BAUMAU1/FW-190---RC-AIRPLANE/Demo videos/Controller_backpack.jpeg

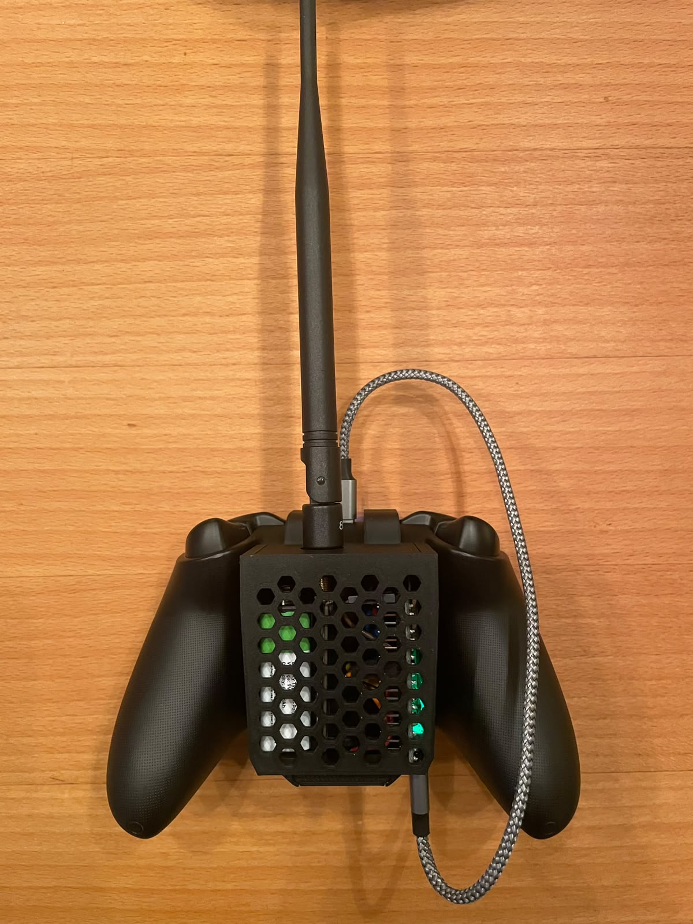
Demo videos/Controller_backpack.jpeg
