BAUMAU1/FW-190---RC-AIRPLANE/Demo videos/Nose-tray.jpeg

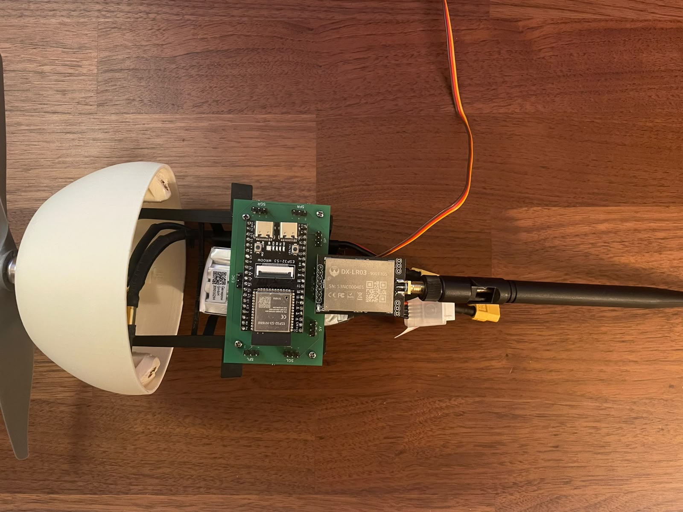
Demo videos/Nose-tray.jpeg
