BAUMAU1/FW-190---RC-AIRPLANE/Parts/BOM - Tabellenblatt1 (1).csv

Item name | Quantity | Price in Euro | Item link | Notes
ASA Aero Filament | 1 | 51,99 | https://eu.store.bambulab.com/de/products/asa-aero | Any other producer and other light weight filament works too
PETG Filament | 1 | 15,99 | https://eu.store.bambulab.com/de/products/petg-basic?id=703100873995440140 | Any other producer works too
ESP32 S3 CAM | 2 | 8,6 | https://www.ebay.de/itm/158230133114?_skw=ESP32-S3+CAM&itmmeta=01M6K4JS280QW6J4A2HHVTWYCD
DX-LR03 | 2 | 16,69 | https://de.aliexpress.com/item/1005008388886852.html?src=google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 | Two antennas needed, but only one order from this link
MG90S Servo | 4 | 16 | https://www.ebay.de/itm/157945572584 | One servo too much, but same price as less
Miuzei MS18 Servo | 1 | 6,99 | https://www.amazon.de/Miuzei-Hubschrauber-Helikopter-Fahrzeugmodelle-Steuerung/dp/B0BH6PD87V | Specific model because it will be deconstructed for specific parts
5V Step Down converter | 1 | 3,39 | https://www.ebay.de/itm/375340664282?_skw=step+down+5v&itmmeta=01M6K8TPDH68TE3QB4668P6WJX&var=644317386672
9V Battery | 1 | 9,9 | https://www.ebay.de/itm/389540519821?var=656860239995
1,5mm x 3 x 330mm springsteel wire | 1 | 3,5 | https://www.ebay.de/itm/175584943363?var=475856438007 | More wire than needed
2,5mm x 3 x 330 | 1 | 4,4 | https://www.ebay.de/itm/175584943363?var=475856438010 | Wire does not have to be cut prior to own modifications
3D-Weld | 1 | 13,5 | https://www.krickshop.de/Solid-Water-90-ml-DELUXE-Materials.htm?a=article&ProdNr=44110&p=1017
Heat Brass insert | 2 | 1,43 | https://eu.store.bambulab.com/de/products/round-threaded-brass-heat-insert-nut | M2x3,5x6
Heat Brass insert | 4 | 1,47 | https://eu.store.bambulab.com/de/products/round-threaded-brass-heat-insert-nut | M3x5x4
Heat Brass insert | 8 | 1,49 | https://eu.store.bambulab.com/de/products/round-threaded-brass-heat-insert-nut | M4x6x6
3D-print screw | 2 | 2,49 | https://eu.store.bambulab.com/de/products/bt2-6-socket-head-cap-self-tapping-screw-shcs | BT2,6x8
M2 DIN 7985 screws | 8 | 3,88 | https://www.ebay.de/itm/162173125805?_skw=M2+DIN+7985&itmmeta=01M6K5JG54YVW8JZZRQR3KY1AN&var=461146524234 | One order of 20 pieces of 8mm length
M2,5 DIN 7985 screws | 6 | 2,73 | https://www.ebay.de/itm/162173125925?var=461146524396 | One order of 20 pieces of 5mm length
M3 DIN 7985 screws | 4 | 3,82 | https://www.ebay.de/itm/162173126063?_skw=M3+DIN+7985&itmmeta=01M6K5YNHCN7N69640593T7MPP&var=461146524522 | One orer of 20 pieces of 10mm length
M4 DIN 7985 screws | 2 | 3,89 | https://www.ebay.de/itm/371713578736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 | One orer of 20 pieces of 10mm length
Back-wheel | 1 | 1,5 | https://www.krickshop.de/Zubehoer-Ersatzteile/Zubehoer-fuer-Flugmodelle/Raeder/Flugmodellrad-19mm-ALU-Felge.htm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
Front Wheels | 2 | 5,7 | https://www.krickshop.de/Zubehoer-Ersatzteile/Zubehoer-fuer-Flugmodelle/Raeder/Flug-Reifen-37mm-2-.htm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
AL2835-6 Motor | 1 | 33,9 | https://www.d-power-modellbau.com/motoren/brushless-motoren/d-power-al-serie---flug/d-power-al-2835-6-brushless-motor
Comet 40A BEC | 1 | 23,12 | https://www.modellbau-skeries.de/p/d-power-comet-40a-bec-brushless-regler | Does not have to be exact model
 | MAX. Price ==> | 244,97
