BAUMAU1/FW-190---RC-AIRPLANE/3D-model/Basic filament-parts.3mf

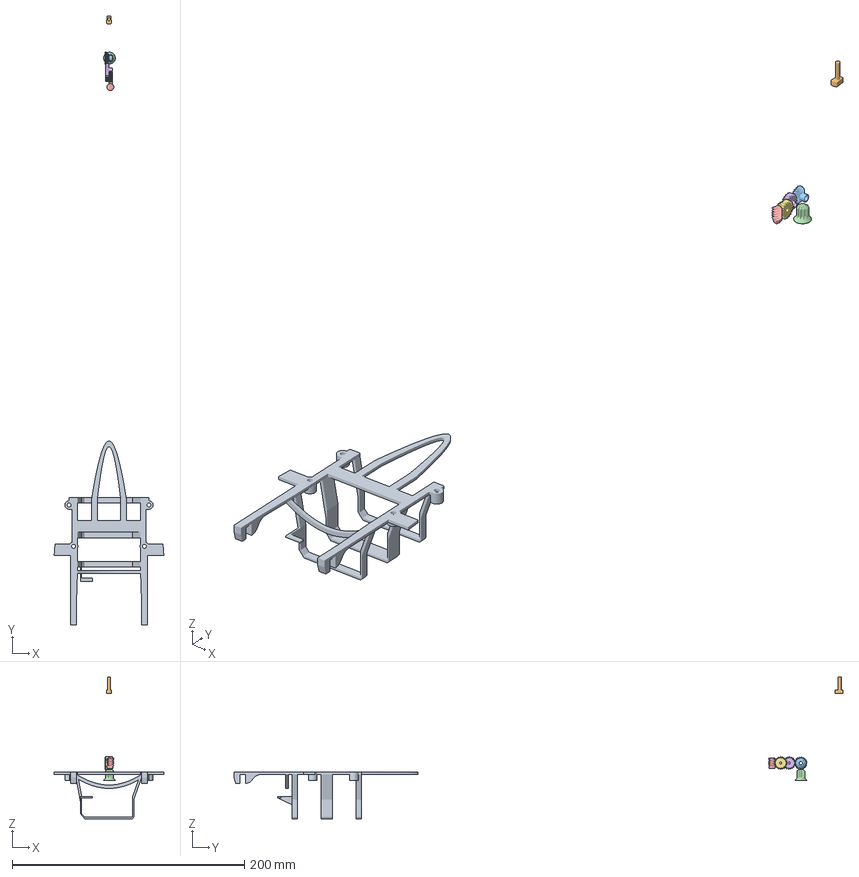
[picture p4: CAD file, 2026-11-01]
3D-model/Basic filament-parts.3mf
94.5 x 524.1 x 121.9 mm
Halterung innen
Heckflügelblocker
Höhenruderstangenrahnrad
Potentiometerrad
Servomotorzahnradaufsatz
Zahnrad M
Zahnrad V
