BAUMAU1/FW-190---RC-AIRPLANE/3D-model/Bambu slicer FW 190 model.3mf.stl

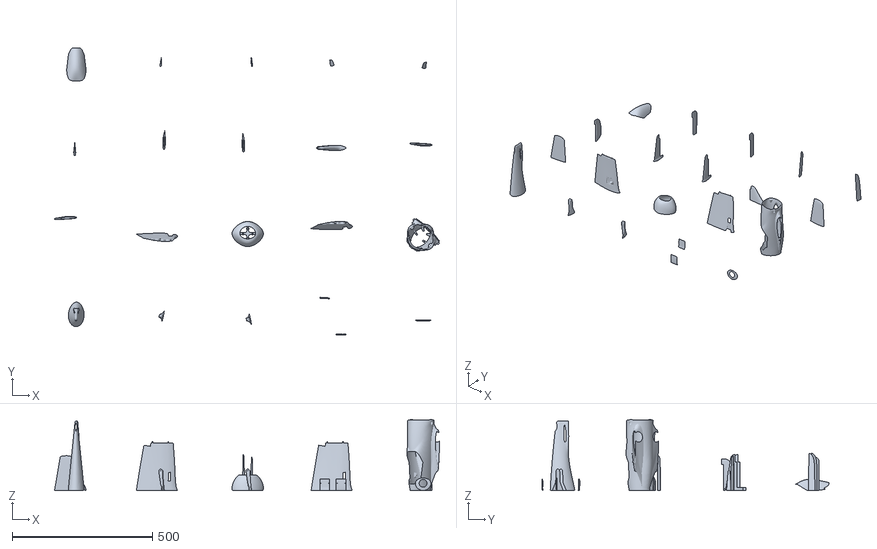
[picture p5: CAD file, 2026-11-01]
3D-model/Bambu slicer FW 190 model.3mf.stl
1374.8 x 1026.5 x 253.6
