BAUMAU1/FW-190---RC-AIRPLANE/3D-model/FW 190 model.3mf

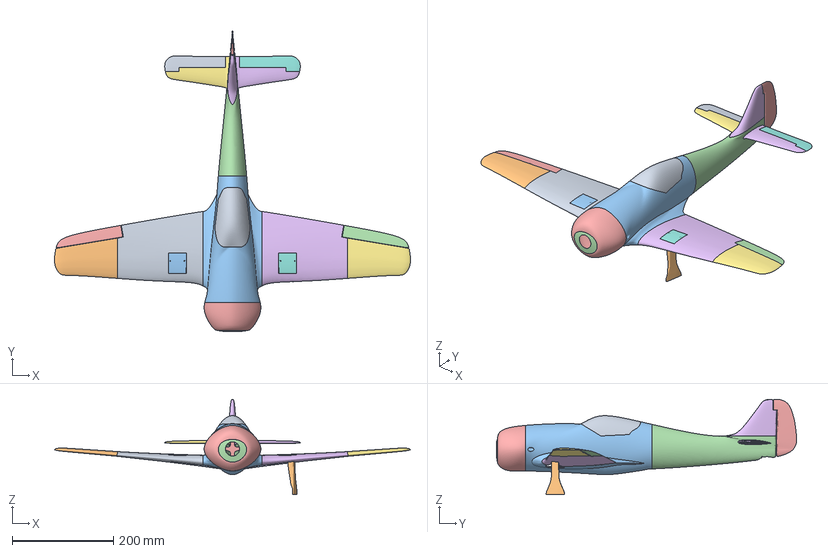
[picture p6: CAD file, 2026-11-01]
3D-model/FW 190 model.3mf
703.0 x 593.0 x 188.2 mm
Cockpit
Fahrwerk L
Flugzeugrumpf 1
Flugzeugrumpf 2
Flugzeugrumpf Schnauze
Flügel Links 1
Flügel Links 2
Flügel Links Servoabdeckung
Flügel Rechts 1
Flügel Rechts 2
Flügel Rechts Servoabdeckung
Frontabdeckung
Heckflosse
Heckflügel L
Heckflügel R
Höhenruder L
Höhenruder R
Höhenruderstangenrahnrad
Potentiometerrad
Ruder FvL
Ruder FvR
Rumpf2 Finne
Servomotorzahnradaufsatz
Zahnrad M
Zahnrad V
