BAUMAU1/FW-190---RC-AIRPLANE/(list of files, cad)

Other CAD files:
3D-model/Controller-Esp Backpack.step
3D-model/Entire FW 190 modell.step
