BAUMAU1/FW-190---RC-AIRPLANE/(commit log)

2026-10-31 Implement sender code for Gulikit KK3 Pro controller
    This code is designed for the Gulikit KK3 Pro controller, enabling communication through two DX-LR03 antennas and ESP32 S3. It includes setup for USB device connection and HID input handling.
    Unfinished
2026-10-31 Add receiver functionality for ESP32 and DX-LR03
    Implement receiver code for ESP32 with DX-LR03 antennas.
    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
2026-10-31 Add placeholder for Bambu slicer print-parts
    Added a placeholder for a new file.
2026-10-31 Add printing notes to 3D model CAD file
    Added notes for printing with different filament or printer.
2026-10-31 Update construction instructions with additional steps
    Added details about printing parts and setting up electronics.
2026-10-31 Refactor receiver code and update servo handling
    Refactor receiver code to improve functionality and readability.
2026-10-31 Add DXLR03 class for Arduino communication
2026-10-31 Rename 3d-model CAD to 3D-model/READme
2026-10-31 Create README for ESP32 S3 CAM receiver
    Added README with project overview and library requirement.
2026-10-31 Create README for firmware transmitter
    Added documentation for the ESP32 S3 CAM transmitter.
2026-10-31 Revise README with 3D model and slicer information
    Updated README to include details about the 3D model and slicer version for ASA Aero filament.
2026-11-01 Update README with print settings advice
    Added a note about modifying print settings for better results.
2026-11-01 Revise electronics and hardware assembly steps
    Updated construction instructions for electronics setup and hardware preparation.
2026-11-01 Update README with details on basic filament parts
    Added information about basic filament parts file.
2026-11-01 Add 3D print glue and hot glue to parts list
2026-11-01 Update construction instructions with detailed steps
    Added detailed steps for construction, including printing parts, setting up electronics, and preparing hardware.
2026-11-01 Create Servo deconstructed
2026-11-01 Fix image link for servo deconstruction
    Updated image link format for clarity.
2026-11-01 Update construction instructions for hardware setup
    Added instruction to solder pins on PCB and ESP32 if necessary.
2026-11-01 Update construction instructions for servo installation
    Added instructions for securing servos in the wings.
2026-11-01 Fix image link for wing servo in instructions
    Updated image reference for wing servo in construction instructions.
2026-11-01 Update construction instructions with hardware details
    Added detailed instructions for inserting heat-brass inserts and securing components in the construction process.
2026-11-01 Modify gear logic and update servo control parameters
2026-11-01 Clarify MS18 servo deconstruction steps
    Updated step 2 to clarify the deconstruction of the MS18 servo and the order of operations for soldering.
2026-11-01 Fix image reference for wing hull in instructions
    Corrected the image file name to match the actual case.
2026-11-01 Enhance construction instructions with wire bending steps
    Added instructions for bending wire and aligning wings.
2026-11-01 Update spring steel wire description in parts list
2026-11-03 Update parts list with new motor specifications
2026-11-03 Update README to clarify servomotor issue
    Corrected terminology from 'motor' to 'servomotor' for clarity.
2026-11-04 Add STEP model using Git LFS
    [Entire FW 190 modell.step]
2026-11-04 Update README with transmitting ESP32 details
    Added details about the transmitting ESP32 enclosure and components.
2026-11-04 Add warning for step-down converter safety
    Added a warning about covering the step-down converter's contacts to prevent short circuits.
2026-11-04 Update BOM by removing items and adjusting details
    Removed several items from the BOM including various filaments, components, and screws. Updated prices and links for remaining items.
    [BOM - Tabellenblatt1.csv]
